TechImagine3D/Robot-cuadrupedo-controlado-por-bluetooth/DATOS_KACHOKAME/IMAGENES/IMG_20170301_224827.jpg

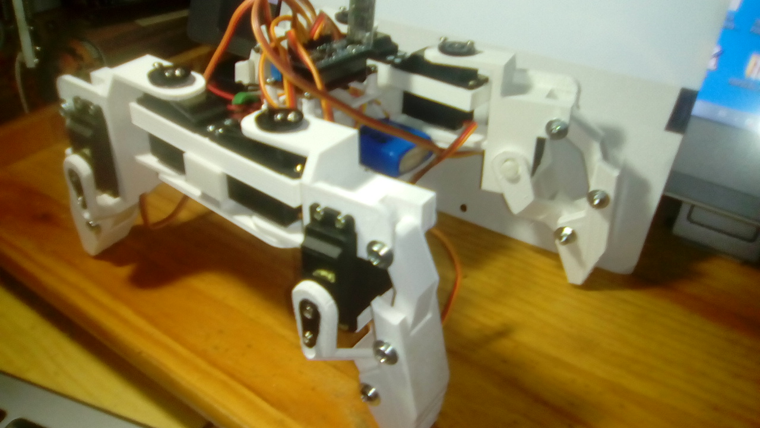
DATOS_KACHOKAME/IMAGENES/IMG_20170301_224827.jpg
