TechImagine3D/Robot-cuadrupedo-controlado-por-bluetooth/README.md

# robot-cuadrupedo-controlado-por-bluetooth
Diseño de un robot cuadrúpedo controlado con bluetooth con arduino y AppInventor
