TechImagine3D/Robot-cuadrupedo-controlado-por-bluetooth/DATOS_KACHOKAME/PCB_PLACA/PCB_ARDUINO.pdf

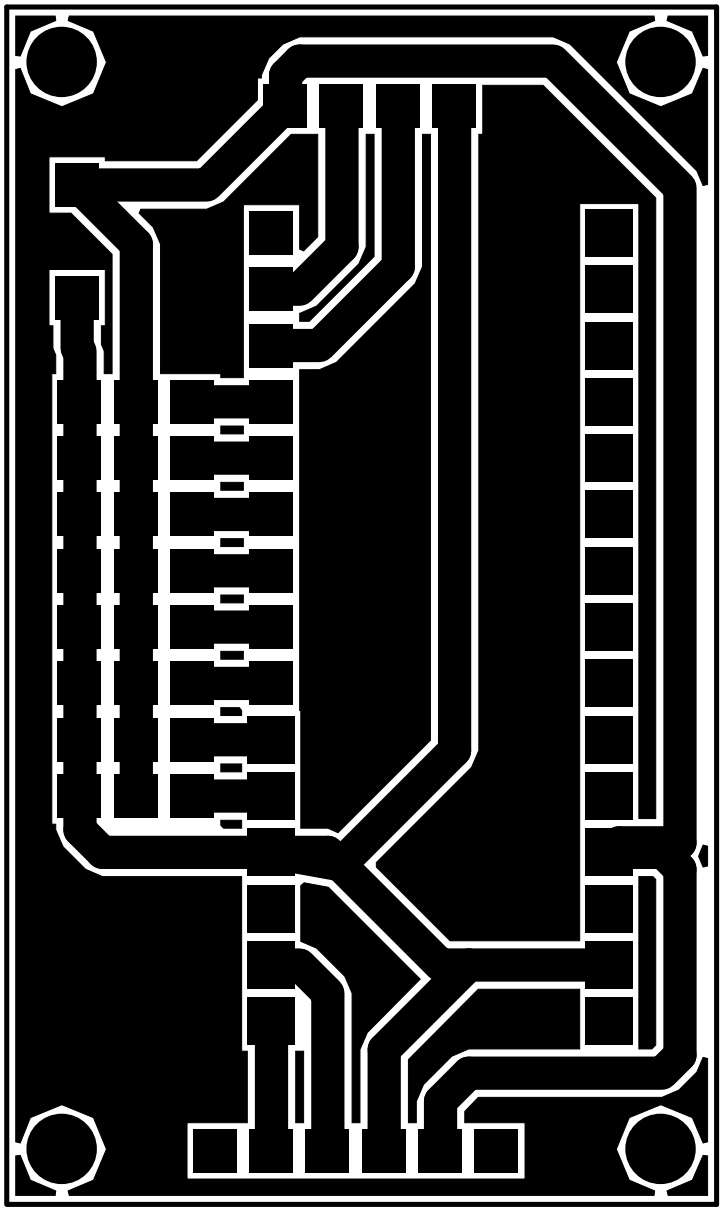
[picture p22: figure]

CAMtasticDXP (TM):
