TechImagine3D/Robot-cuadrupedo-controlado-por-bluetooth/DATOS_KACHOKAME/IMAGENES/2017-03-07 23_35_47-ESQUEMA_KACHOKAME.fzz_ - Fritzing - [Vista de Protoboard (placa de Prototipos)].png

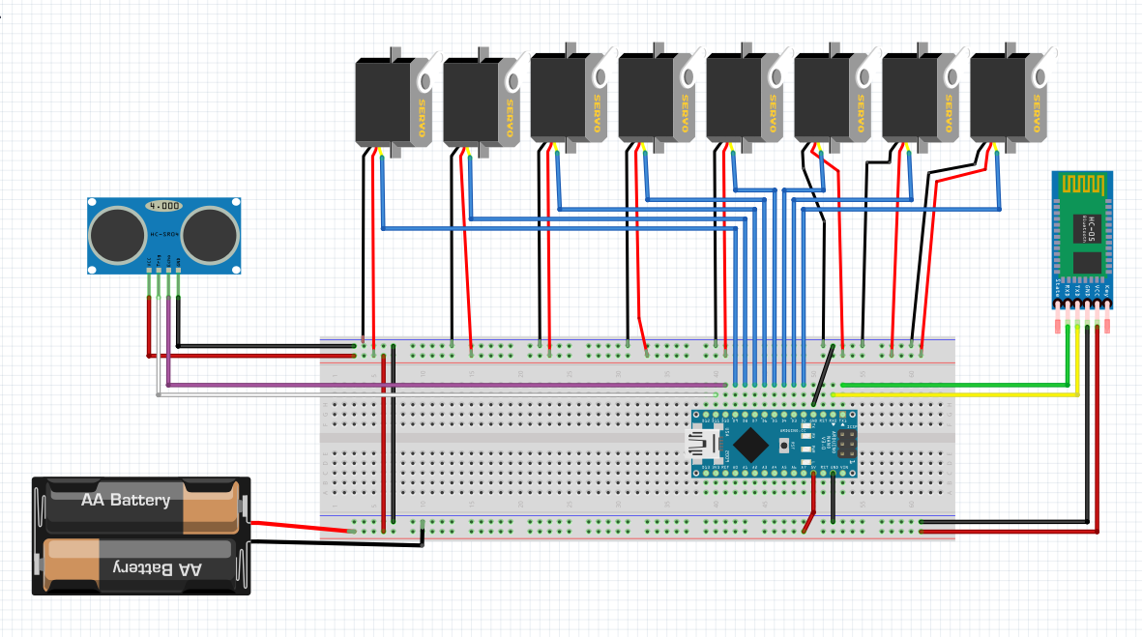
DATOS_KACHOKAME/IMAGENES/2017-03-07 23_35_47-ESQUEMA_KACHOKAME.fzz_ - Fritzing - [Vista de Protoboard (placa de Prototipos)].png
