TechImagine3D/Robot-cuadrupedo-controlado-por-bluetooth/DATOS_KACHOKAME/IMAGENES/2017-03-07 23_37_22-Altium Designer (13.2) - G__DATOS_TRABAJOS_PENDIENTES_KACHOKAME_DATOS_KACHOKAME_.png

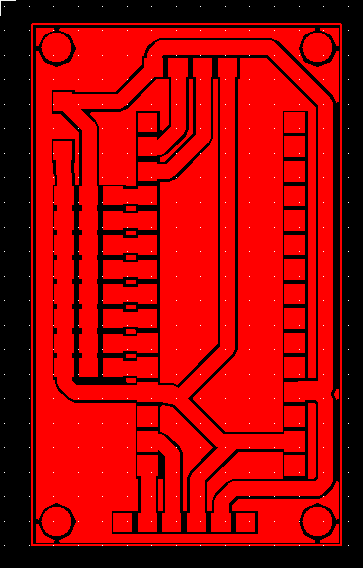
DATOS_KACHOKAME/IMAGENES/2017-03-07 23_37_22-Altium Designer (13.2) - G__DATOS_TRABAJOS_PENDIENTES_KACHOKAME_DATOS_KACHOKAME_.png
