TechImagine3D/Robot-cuadrupedo-controlado-por-bluetooth/DATOS_KACHOKAME/IMAGENES/2017-03-14 21_22_26-CAMTASTIC.pdf.png

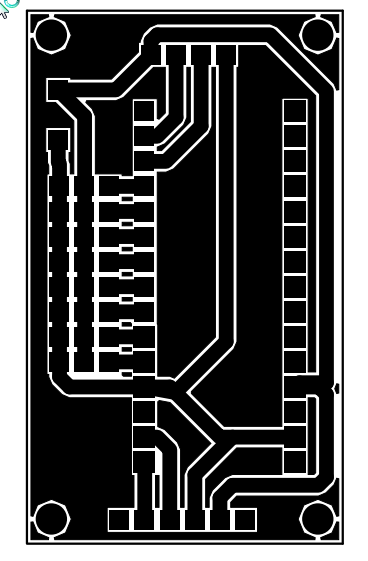
DATOS_KACHOKAME/IMAGENES/2017-03-14 21_22_26-CAMTASTIC.pdf.png
