TechImagine3D/Robot-cuadrupedo-controlado-por-bluetooth/DATOS_KACHOKAME/IMAGENES/ESQUEMA.png

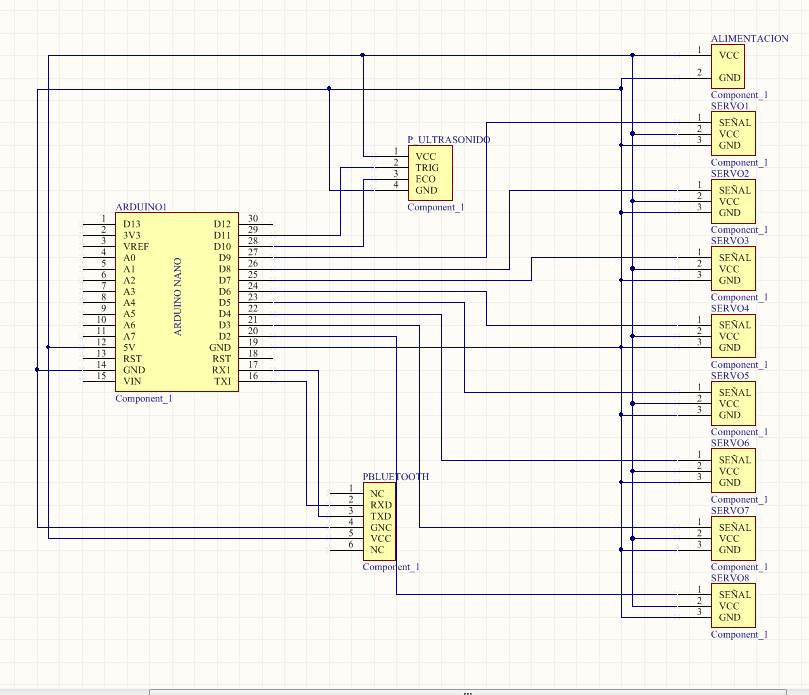
DATOS_KACHOKAME/IMAGENES/ESQUEMA.png
