TechImagine3D/Robot-cuadrupedo-controlado-por-bluetooth/DATOS_KACHOKAME/IMAGENES/IMG_20170301_224855.jpg

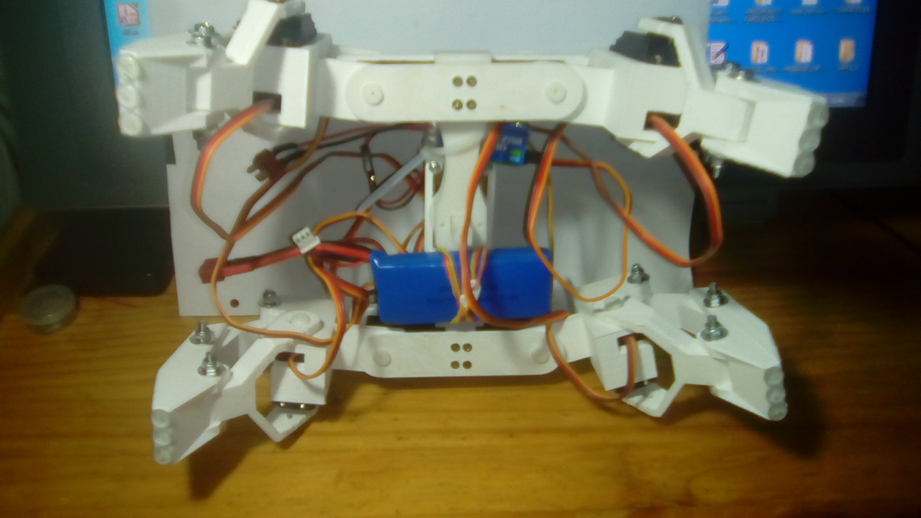
DATOS_KACHOKAME/IMAGENES/IMG_20170301_224855.jpg
