TechImagine3D/Robot-cuadrupedo-controlado-por-bluetooth/DATOS_KACHOKAME/IMAGENES/PCB.png

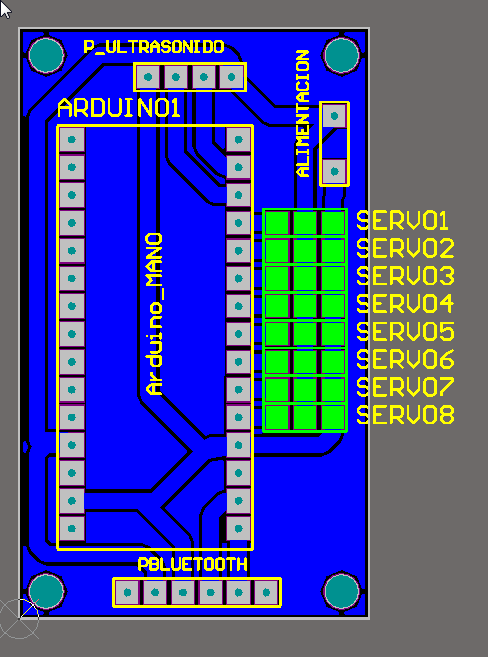
DATOS_KACHOKAME/IMAGENES/PCB.png
