TechImagine3D/Robot-cuadrupedo-controlado-por-bluetooth/DATOS_KACHOKAME/DISEÑO_STL/SOPORTE_CENTRAL_ARDUINO.stl

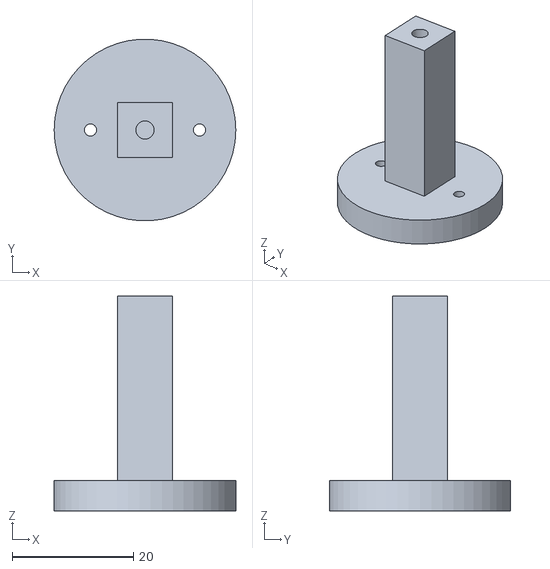
[picture p30: CAD file, 2019-07-07]
DATOS_KACHOKAME/DISEÑO_STL/SOPORTE_CENTRAL_ARDUINO.stl
30.0 x 29.9 x 35.5
