TechImagine3D/Robot-cuadrupedo-controlado-por-bluetooth/DATOS_KACHOKAME/DISEÑO_STL/BOTON_EJES.stl

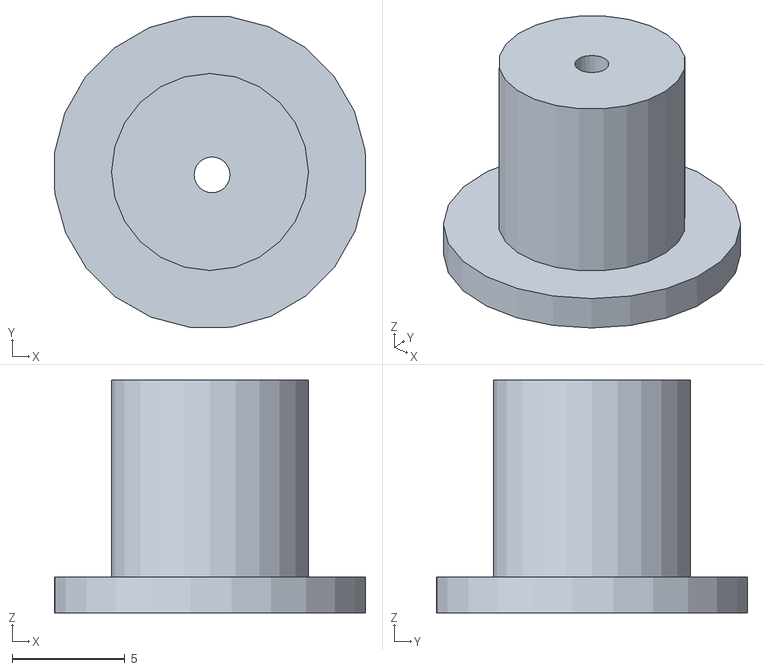
[picture p31: CAD file, 2019-07-07]
DATOS_KACHOKAME/DISEÑO_STL/BOTON_EJES.stl
13.8 x 13.8 x 10.3
