TechImagine3D/Robot-cuadrupedo-controlado-por-bluetooth/DATOS_KACHOKAME/DISEÑO_STL/BRAZO_SUPERIOR.STL

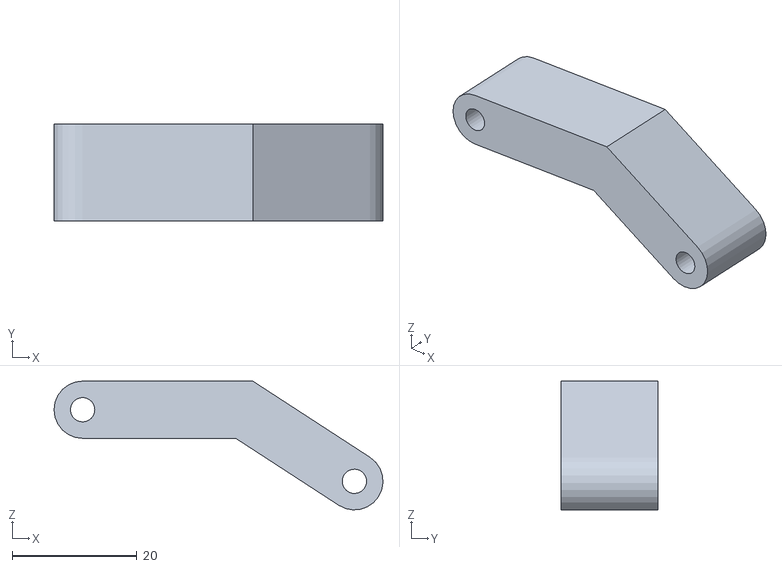
[picture p32: CAD file, 2019-07-07]
DATOS_KACHOKAME/DISEÑO_STL/BRAZO_SUPERIOR.STL
52.7 x 15.5 x 20.6
