TechImagine3D/Robot-cuadrupedo-controlado-por-bluetooth/DATOS_KACHOKAME/DISEÑO_STL/BRAZOS_NUEVOS.stl

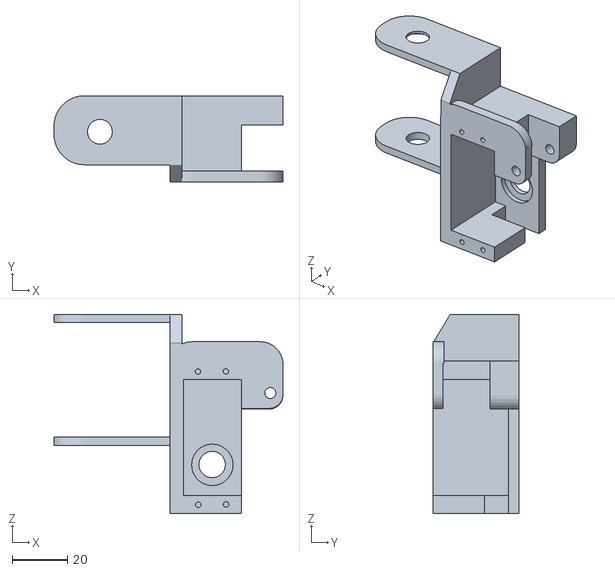
[picture p33: CAD file, 2019-07-07]
DATOS_KACHOKAME/DISEÑO_STL/BRAZOS_NUEVOS.stl
83.0 x 31.3 x 72.2
