TechImagine3D/Robot-cuadrupedo-controlado-por-bluetooth/DATOS_KACHOKAME/DISEÑO_STL/SOPORTE_CENTRAL_PATAS.stl

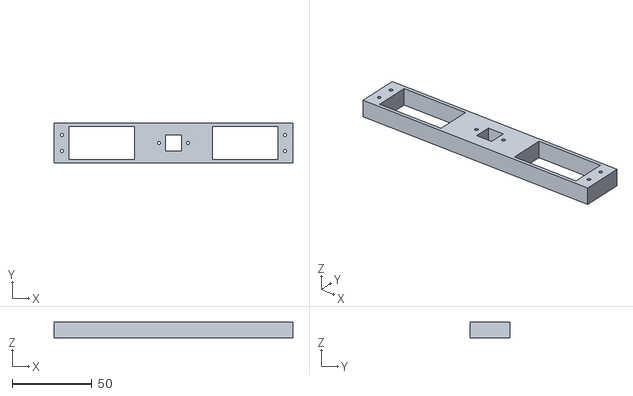
[picture p34: CAD file, 2019-07-07]
DATOS_KACHOKAME/DISEÑO_STL/SOPORTE_CENTRAL_PATAS.stl
150.0 x 25.0 x 10.0
