TechImagine3D/Robot-cuadrupedo-controlado-por-bluetooth/DATOS_KACHOKAME/DISEÑO_STL/SOPORTE_PLACA.stl

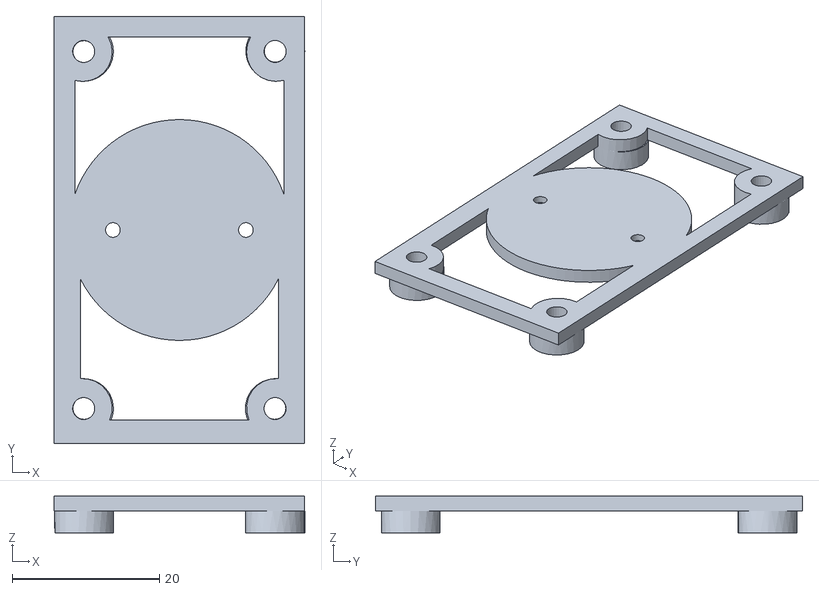
[picture p35: CAD file, 2019-07-07]
DATOS_KACHOKAME/DISEÑO_STL/SOPORTE_PLACA.stl
34.0 x 58.0 x 5.00
