TechImagine3D/Robot-cuadrupedo-controlado-por-bluetooth/DATOS_KACHOKAME/DISEÑO_STL/BRAZO_INFERIOR.STL

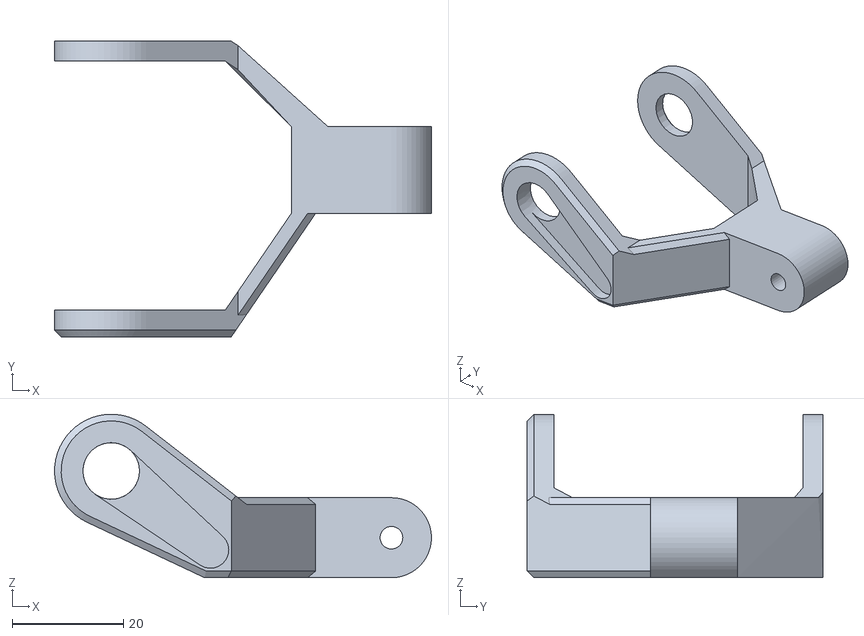
[picture p36: CAD file, 2019-07-07]
DATOS_KACHOKAME/DISEÑO_STL/BRAZO_INFERIOR.STL
67.9 x 53.2 x 29.4
