TechImagine3D/Robot-cuadrupedo-controlado-por-bluetooth/DATOS_KACHOKAME/DISEÑO_STL/ARANDERA.stl

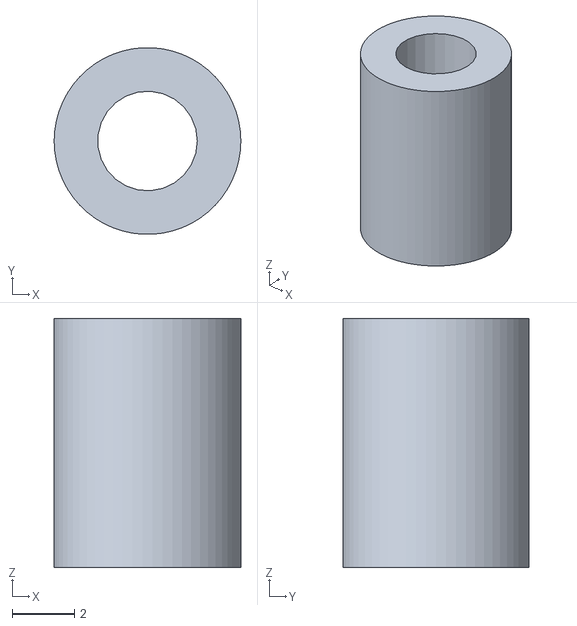
[picture p37: CAD file, 2019-07-07]
DATOS_KACHOKAME/DISEÑO_STL/ARANDERA.stl
6.00 x 5.99 x 8.00
