TechImagine3D/Robot-cuadrupedo-controlado-por-bluetooth/DATOS_KACHOKAME/DISEÑO_STL/SOPORTE_SERVO_EXTREMO.stl

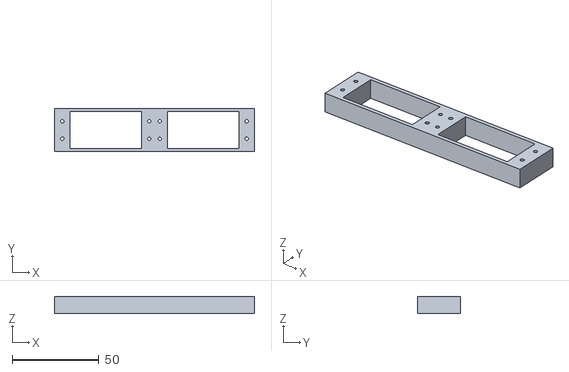
[picture p38: CAD file, 2019-07-07]
DATOS_KACHOKAME/DISEÑO_STL/SOPORTE_SERVO_EXTREMO.stl
115.0 x 25.0 x 10.0
