TechImagine3D/Robot-cuadrupedo-controlado-por-bluetooth/DATOS_KACHOKAME/DISEÑO_STL/PATA_ALARGADA.STL

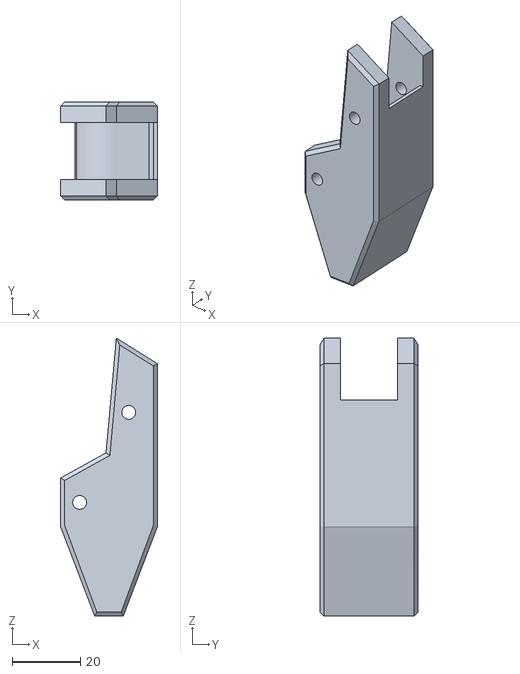
[picture p39: CAD file, 2019-07-07]
DATOS_KACHOKAME/DISEÑO_STL/PATA_ALARGADA.STL
28.4 x 28.8 x 81.6
