TechImagine3D/Robot-cuadrupedo-controlado-por-bluetooth/DATOS_KACHOKAME/DISEÑO_STL/CHASIS.stl

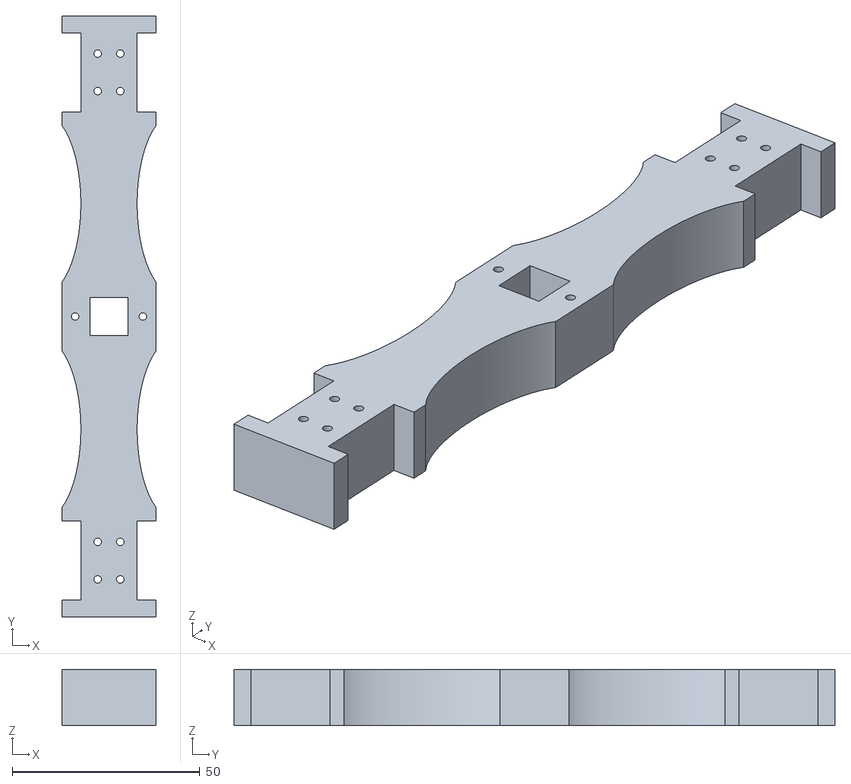
[picture p40: CAD file, 2019-07-07]
DATOS_KACHOKAME/DISEÑO_STL/CHASIS.stl
25.0 x 160.0 x 15.0
