TechImagine3D/Robot-cuadrupedo-controlado-por-bluetooth/DATOS_KACHOKAME/DISEÑO_STL/SOPORTE_AT_INFERIOR.stl

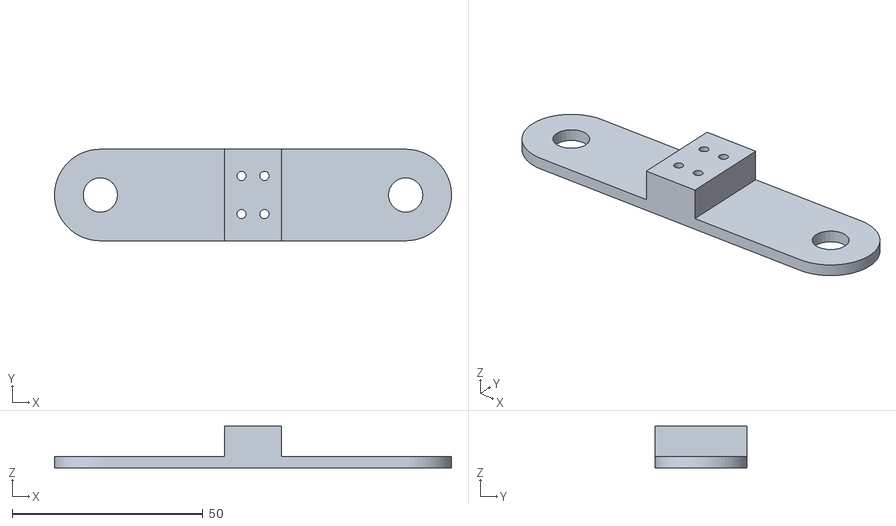
[picture p41: CAD file, 2019-07-07]
DATOS_KACHOKAME/DISEÑO_STL/SOPORTE_AT_INFERIOR.stl
104.0 x 24.0 x 11.0
